NextBG/Filament_LED_Wall/Mechanical/0.2/装配体1.SLDASM

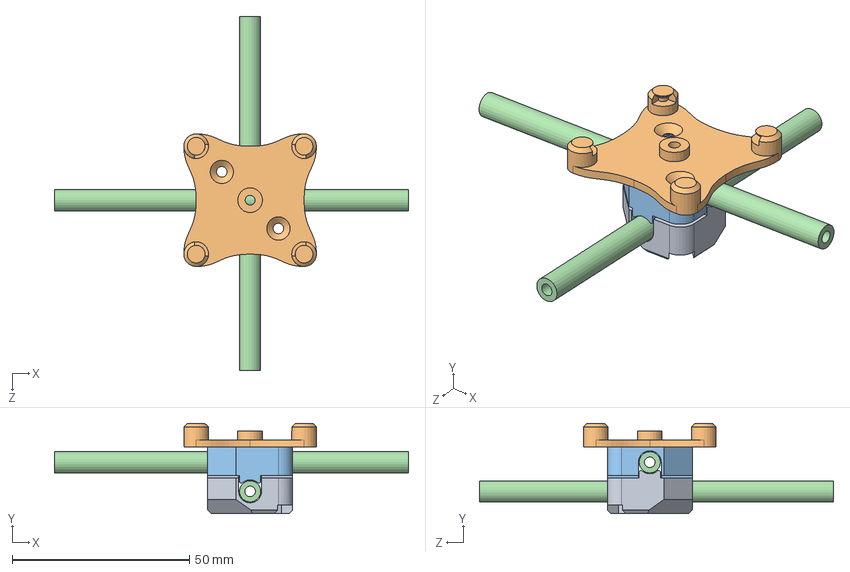
[picture p1: CAD file, 2021-04-25]
Mechanical/0.2/装配体1.SLDASM
100.0 x 25.5 x 100.0 mm
FrameHolder_tail
FrameHolder_mount
FrameHolder_top
Tube_4x6x100 x 2
