NextBG/Filament_LED_Wall/Mechanical/0.1/FrameHolder_Head.SLDPRT

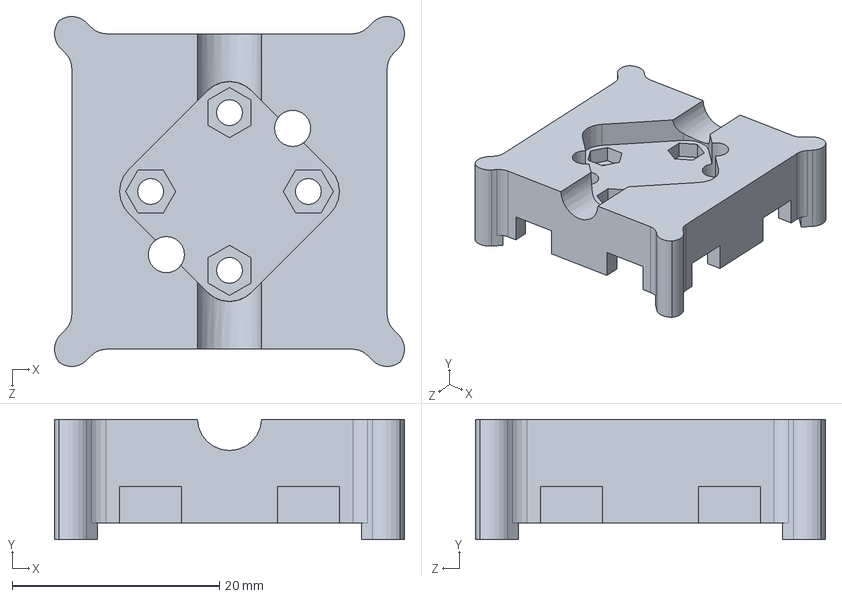
[picture p2: CAD file, 2021-04-15]
Mechanical/0.1/FrameHolder_Head.SLDPRT
33.8 x 11.6 x 33.8 mm
