NextBG/Filament_LED_Wall/Mechanical/0.2/FrameHolder_tail.SLDPRT

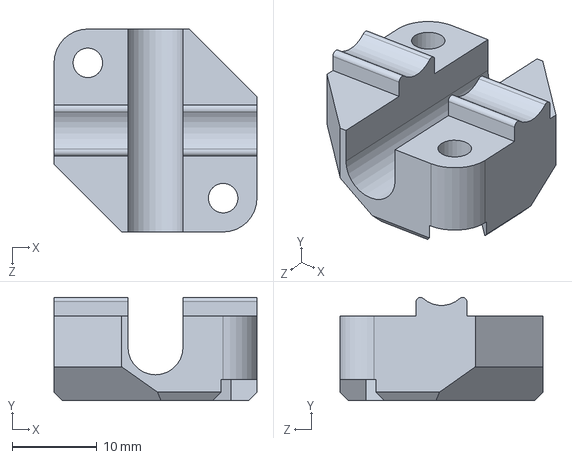
[picture p3: CAD file, 2021-04-25]
Mechanical/0.2/FrameHolder_tail.SLDPRT
24.0 x 12.2 x 24.0 mm
