NextBG/Filament_LED_Wall/Mechanical/0.1/FrameHolder_Tail.SLDPRT

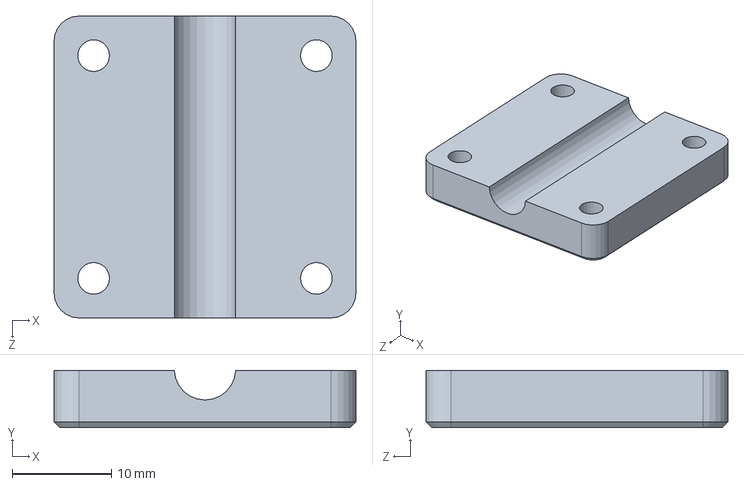
[picture p4: CAD file, 2021-04-15]
Mechanical/0.1/FrameHolder_Tail.SLDPRT
30.5 x 5.80 x 30.5 mm
