NextBG/Filament_LED_Wall/Mechanical/0.2/Tube_4x6x10.SLDPRT

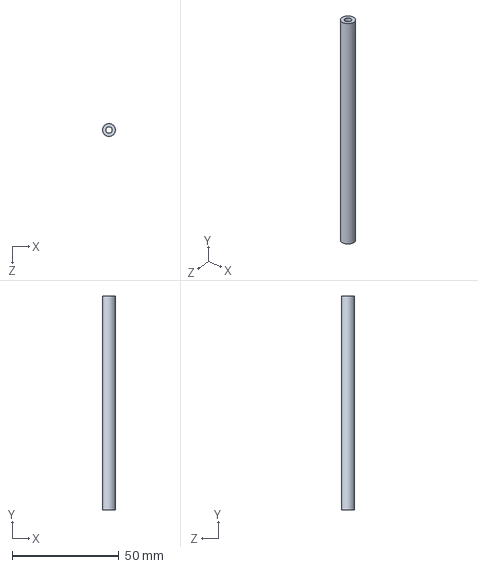
[picture p5: CAD file, 2021-04-25]
Mechanical/0.2/Tube_4x6x10.SLDPRT
6.00 x 100.0 x 6.00 mm
