NextBG/Filament_LED_Wall/Mechanical/0.1/FrameHolder_Middle.SLDPRT

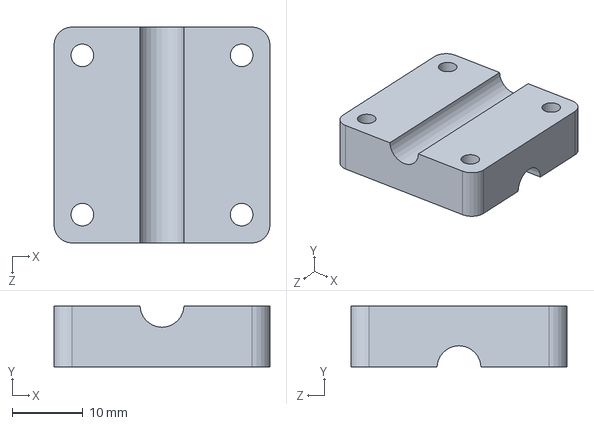
[picture p6: CAD file, 2021-04-15]
Mechanical/0.1/FrameHolder_Middle.SLDPRT
30.5 x 8.60 x 30.5 mm
