NextBG/Filament_LED_Wall/Mechanical/0.2/FrameHolder_mount.SLDPRT

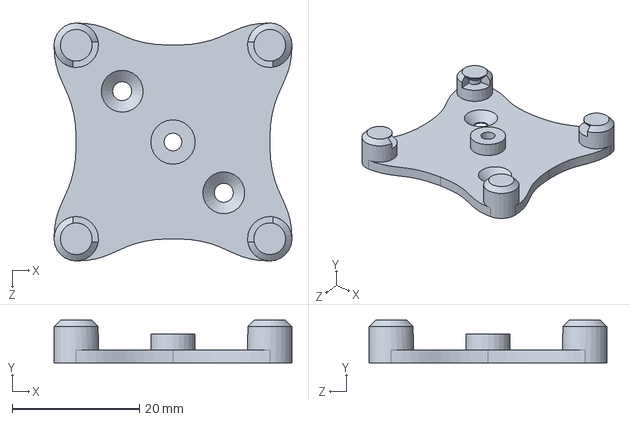
[picture p7: CAD file, 2021-04-25]
Mechanical/0.2/FrameHolder_mount.SLDPRT
37.5 x 6.70 x 37.5 mm
