NextBG/Filament_LED_Wall/Mechanical/0.2/FrameHolder_top.SLDPRT

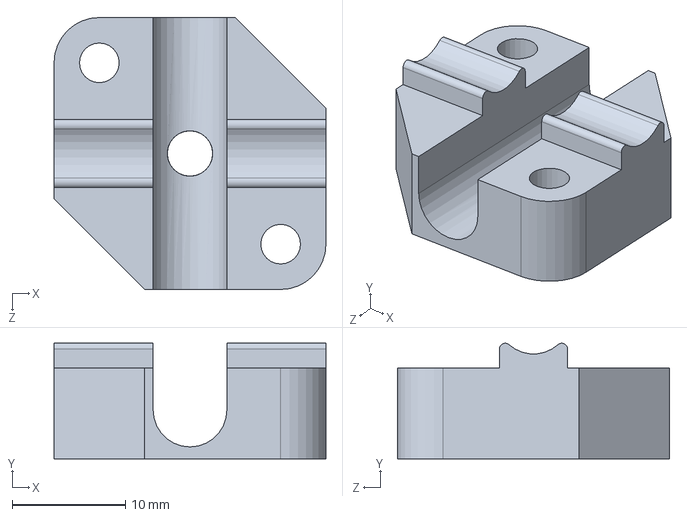
[picture p8: CAD file, 2021-04-25]
Mechanical/0.2/FrameHolder_top.SLDPRT
24.0 x 10.2 x 24.0 mm
