NextBG/Filament_LED_Wall/(list of files, cad)

Other CAD files:
Mechanical/0.2/Tube_4x6x100.SLDPRT
Mechanical/0.1/3DPrinting/FrameHolder_Head.STL
Mechanical/0.1/3DPrinting/FrameHolder_Middle.STL
Mechanical/0.1/3DPrinting/FrameHolder_Tail.STL
Mechanical/0.2/3Dprinting/FrameHolder_mount.STL
Mechanical/0.2/3Dprinting/FrameHolder_tail.STL
Mechanical/0.2/3Dprinting/FrameHolder_top.STL
