NextBG/Filament_LED_Wall/Hardware/FilaDock/fc.kicad_pcb

## KiCad design Hardware/FilaDock/fc.kicad_pcb (2021-09-17)

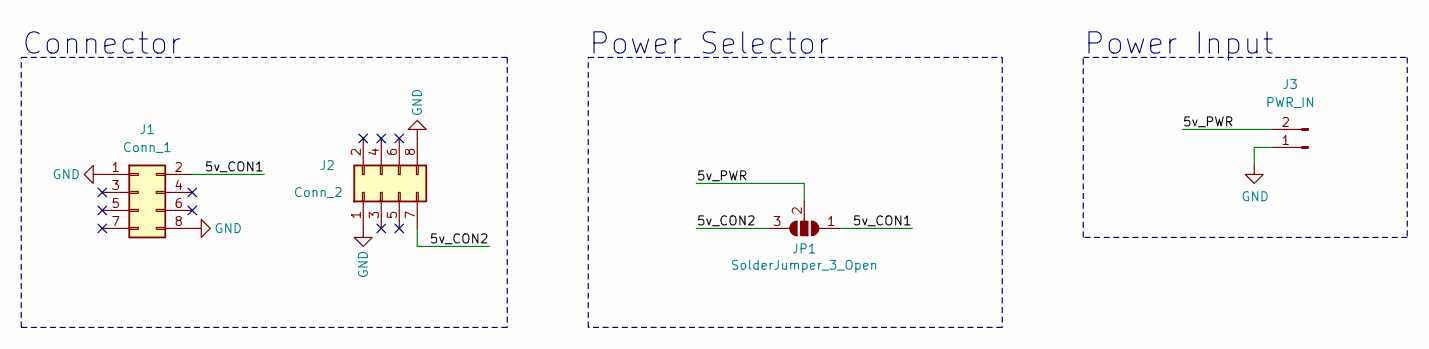
[picture p9: schematic fc.sch]

Parts:
J1: Conn_1; PinSocket_2x04_P2.54mm_Vertical
J2: Conn_2; PinSocket_2x04_P2.54mm_Vertical
J3: PWR_IN; PinHeader_1x02_P2.54mm_Horizontal
JP1: SolderJumper_3_Open; SolderJumper-3_P1.3mm_Open_RoundedPad1.0x1.5mm

Connections:
/5v_CON1: J1.2, JP1.1 (A)
/5v_CON2: J2.7, JP1.3 (B)
/5v_PWR: J3.2, JP1.2 (C)
GND: J1.1, J1.8, J2.1, J2.8, J3.1

Notes on the sheet:
Connector
Power Selector
Power Input

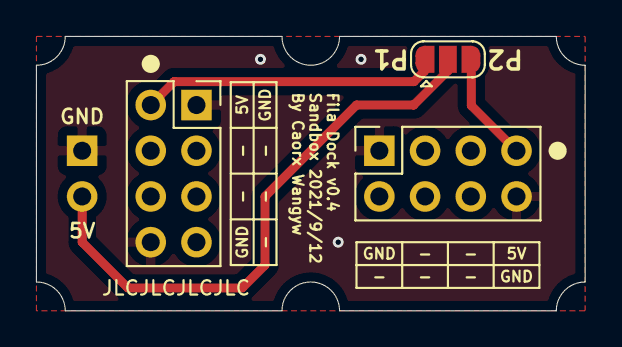
[picture p10: board Hardware/FilaDock/fc.kicad_pcb from above]

Board: 2 copper layers, 30.5 x 15.2 mm, 4 parts (1 on the bottom side), 4 nets.
