NextBG/Filament_LED_Wall/Hardware/FilaHead/fc.kicad_pcb

## KiCad design Hardware/FilaHead/fc.kicad_pcb (2021-05-04)

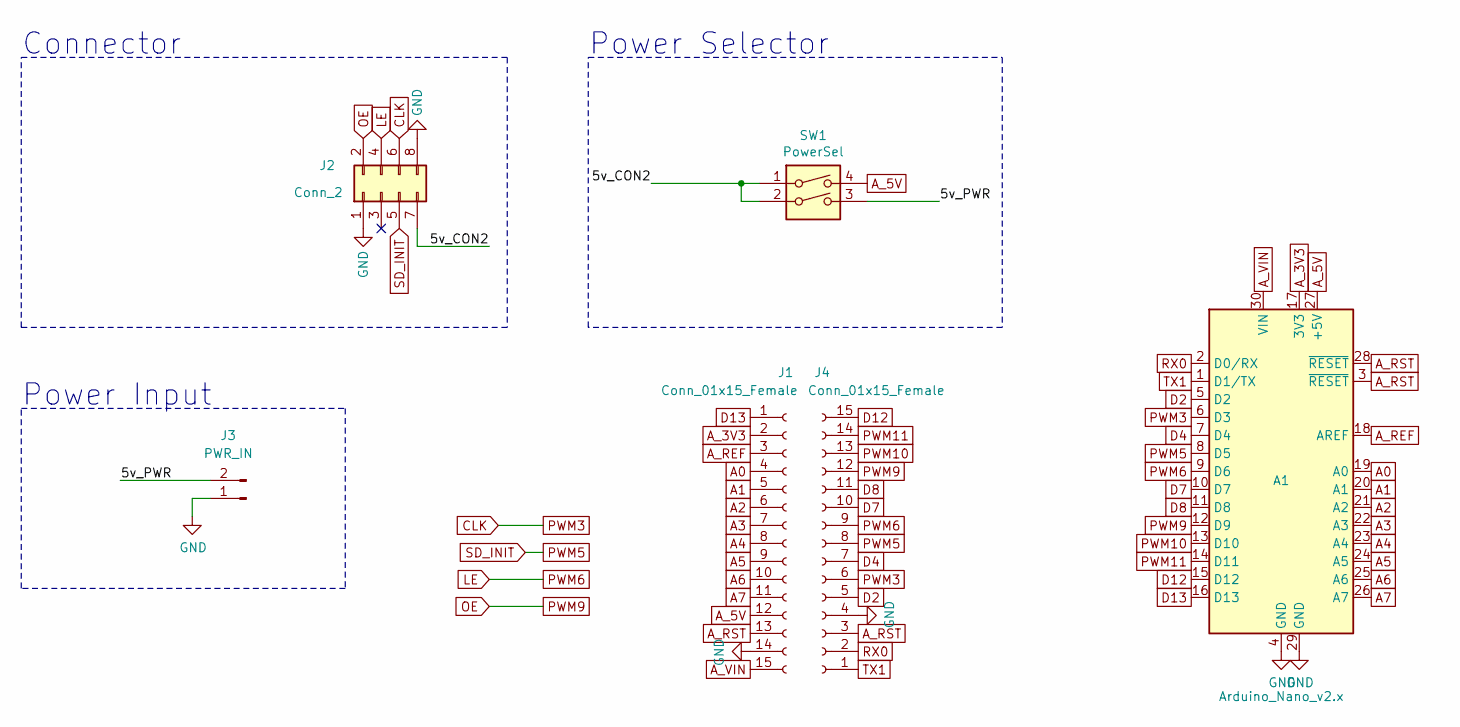
[picture p11: schematic fc.sch]

Parts:
A1: Arduino_Nano_v2.x; Arduino_Nano
J1, J4: Conn_01x15_Female; PinHeader_1x15_P2.54mm_Vertical
J2: Conn_2; PinSocket_2x04_P2.54mm_Vertical
J3: PWR_IN; PinHeader_1x02_P2.54mm_Horizontal
SW1: PowerSel; SW_DIP_SPSTx02_Slide_KingTek_DSHP02TS_W7.62mm_P1.27mm

Connections:
/5v_CON2: J2.7, SW1.1, SW1.2
/5v_PWR: J3.2, SW1.3
A0: A1.19 (A0), J1.4
A1: A1.20 (A1), J1.5
A2: A1.21 (A2), J1.6
A3: A1.22 (A3), J1.7
A4: A1.23 (A4), J1.8
A5: A1.24 (A5), J1.9
A6: A1.25 (A6), J1.10
A7: A1.26 (A7), J1.11
A_3V3: A1.17 (3V3), J1.2
A_5V: A1.27 (+5V), J1.12, SW1.4
A_REF: A1.18 (AREF), J1.3
A_RST: A1.3 (~RESET), A1.28 (~RESET), J1.13, J4.3
A_VIN: A1.30 (VIN), J1.15
CLK: A1.6 (D3), J2.6, J4.6
D2: A1.5 (D2), J4.5
D4: A1.7 (D4), J4.7
D7: A1.10 (D7), J4.10
D8: A1.11 (D8), J4.11
D12: A1.15 (D12), J4.15
D13: A1.16 (D13), J1.1
GND: A1.4 (GND), A1.29 (GND), J1.14, J2.1, J2.8, J3.1, J4.4
LE: A1.9 (D6), J2.4, J4.9
OE: A1.12 (D9), J2.2, J4.12
PWM5: A1.8 (D5), J2.5, J4.8
PWM10: A1.13 (D10), J4.13
PWM11: A1.14 (D11), J4.14
RX0: A1.2 (D0/RX), J4.2
TX1: A1.1 (D1/TX), J4.1

Notes on the sheet:
Connector
Power Selector
Power Input

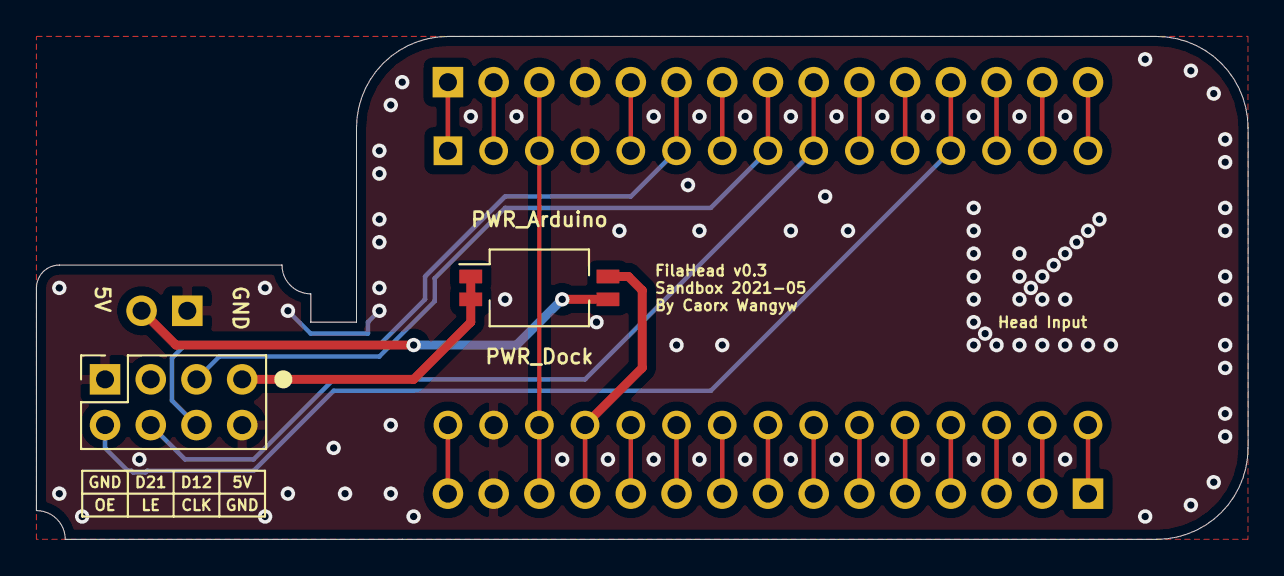
[picture p12: board Hardware/FilaHead/fc.kicad_pcb from above]

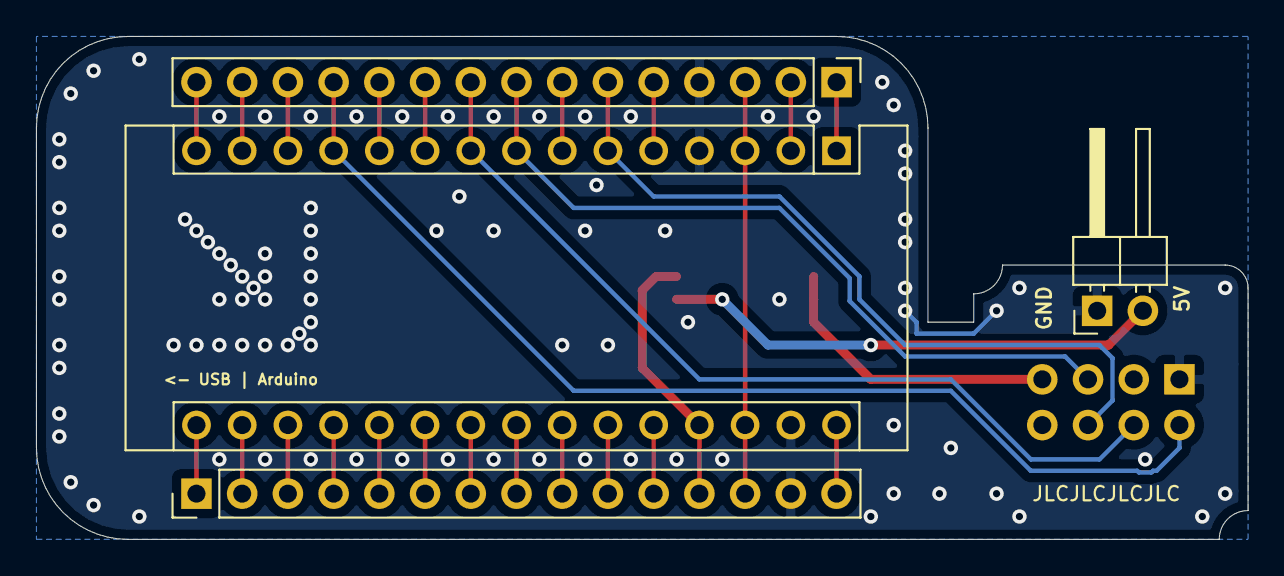
[picture p13: board Hardware/FilaHead/fc.kicad_pcb from below]

Board: 2 copper layers, 67.3 x 27.9 mm, 6 parts (4 on the bottom side), 30 nets.
