NextBG/Filament_LED_Wall/Hardware/FilamentLEDWall/FilamentLEDWall.kicad_pcb

## KiCad design Hardware/FilamentLEDWall/FilamentLEDWall.kicad_pcb (2021-04-15)

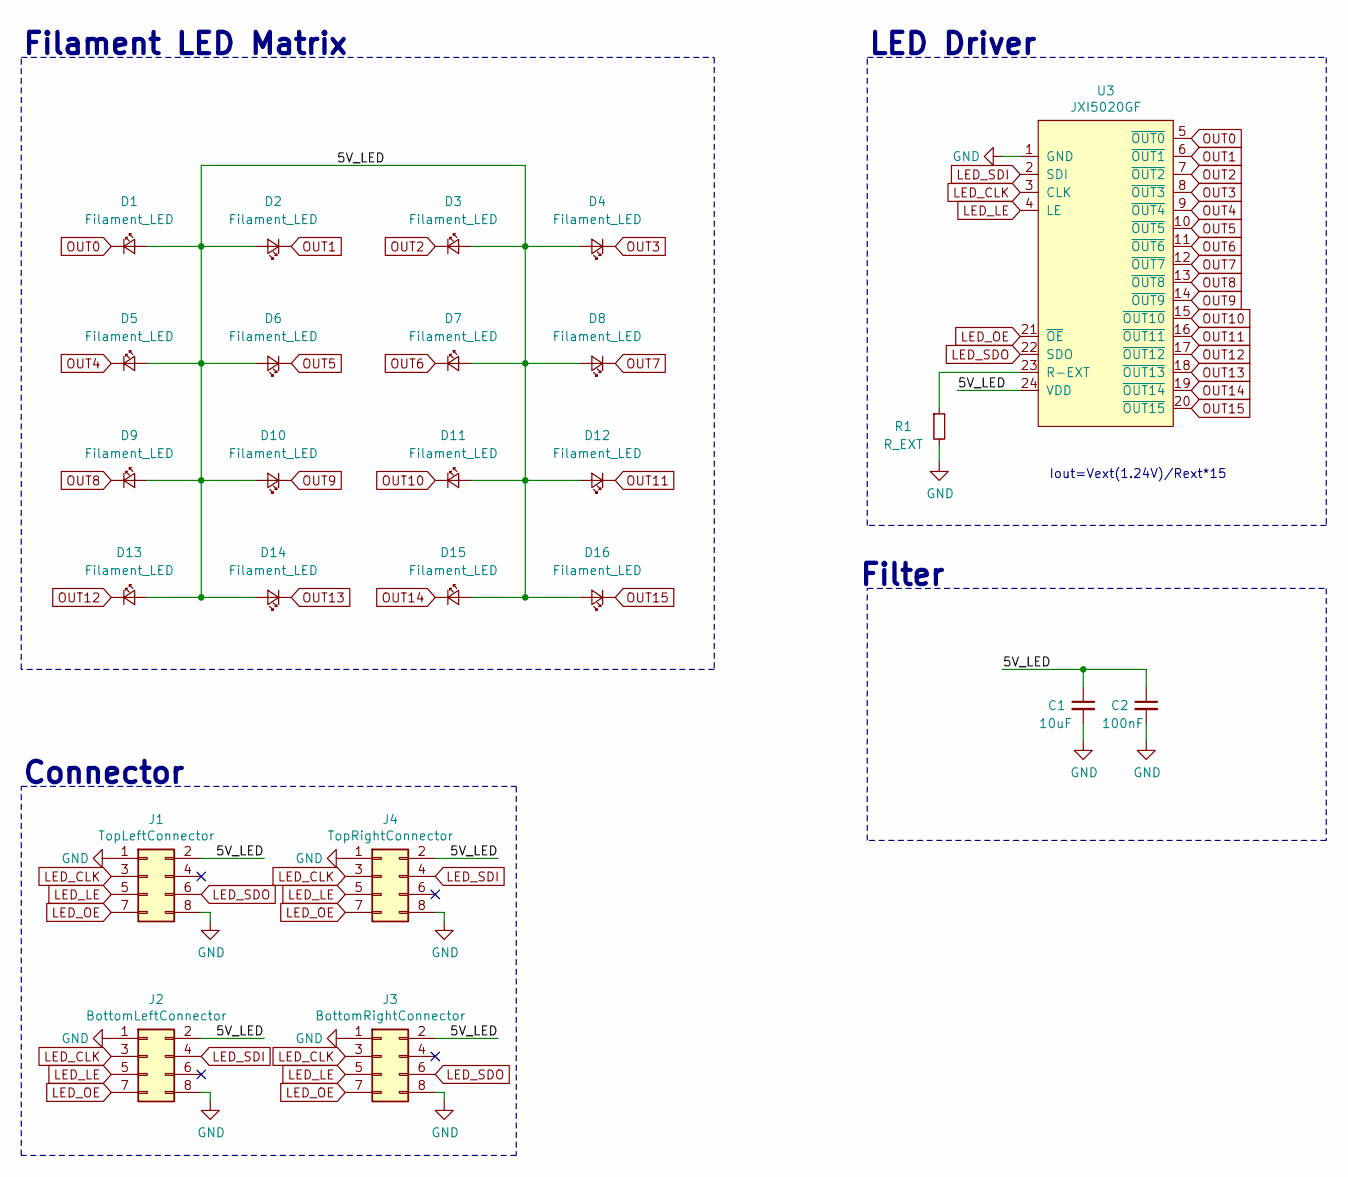
[picture p14: schematic FilamentLEDWall.sch, Filament LED Wall]

Parts:
C1: 10uF; C_0603_1608Metric_Pad1.05x0.95mm_HandSolder
C2: 100nF; C_0603_1608Metric_Pad1.05x0.95mm_HandSolder
D1, D2, D3, D4, D5, D6, D7, D8, D9, D10, D11, D12, D13, D14, D15, D16: Filament_LED; FilamentLED_30mm
J1: TopLeftConnector; PinHeader_2x04_P2.54mm_Vertical_SMD
J2: BottomLeftConnector; PinHeader_2x04_P2.54mm_Vertical_SMD
J3: BottomRightConnector; PinHeader_2x04_P2.54mm_Vertical_SMD
J4: TopRightConnector; PinHeader_2x04_P2.54mm_Vertical_SMD
R1: R_EXT; R_0603_1608Metric_Pad1.05x0.95mm_HandSolder
U3: JXI5020GF; Allegro_QSOP-24_3.9x8.7mm_P0.635mm

Connections:
/5V_LED: C1.1, C2.1, D1.2 (A), D2.2 (A), D3.2 (A), D4.2 (A), D5.2 (A), D6.2 (A), D7.2 (A), D8.2 (A), D9.2 (A), D10.2 (A), D11.2 (A), D12.2 (A), D13.2 (A), D14.2 (A), D15.2 (A), D16.2 (A), J1.2, J2.2, J3.2, J4.2, U3.24 (VDD)
GND: C1.2, C2.2, J1.1, J1.8, J2.1, J2.8, J3.1, J3.8, J4.1, J4.8, R1.2, U3.1 (GND)
LED_CLK: J1.3, J2.3, J3.3, J4.3, U3.3 (CLK)
LED_LE: J1.5, J2.5, J3.5, J4.5, U3.4 (LE)
LED_OE: J1.7, J2.7, J3.7, J4.7, U3.21 (~OE)
LED_SDI: J2.4, J4.4, U3.2 (SDI)
LED_SDO: J1.6, J3.6, U3.22 (SDO)
unnamed: R1.1, U3.23 (R-EXT)
OUT0: D1.1 (K), U3.5 (~OUT0)
OUT1: D2.1 (K), U3.6 (~OUT1)
OUT2: D3.1 (K), U3.7 (~OUT2)
OUT3: D4.1 (K), U3.8 (~OUT3)
OUT4: D5.1 (K), U3.9 (~OUT4)
OUT5: D6.1 (K), U3.10 (~OUT5)
OUT6: D7.1 (K), U3.11 (~OUT6)
OUT7: D8.1 (K), U3.12 (~OUT7)
OUT8: D9.1 (K), U3.13 (~OUT8)
OUT9: D10.1 (K), U3.14 (~OUT9)
OUT10: D11.1 (K), U3.15 (~OUT10)
OUT11: D12.1 (K), U3.16 (~OUT11)
OUT12: D13.1 (K), U3.17 (~OUT12)
OUT13: D14.1 (K), U3.18 (~OUT13)
OUT14: D15.1 (K), U3.19 (~OUT14)
OUT15: D16.1 (K), U3.20 (~OUT15)

Notes on the sheet:
Iout=Vext(1.24V)/Rext*15
LED Driver
Filament LED Matrix
Connector
Filter

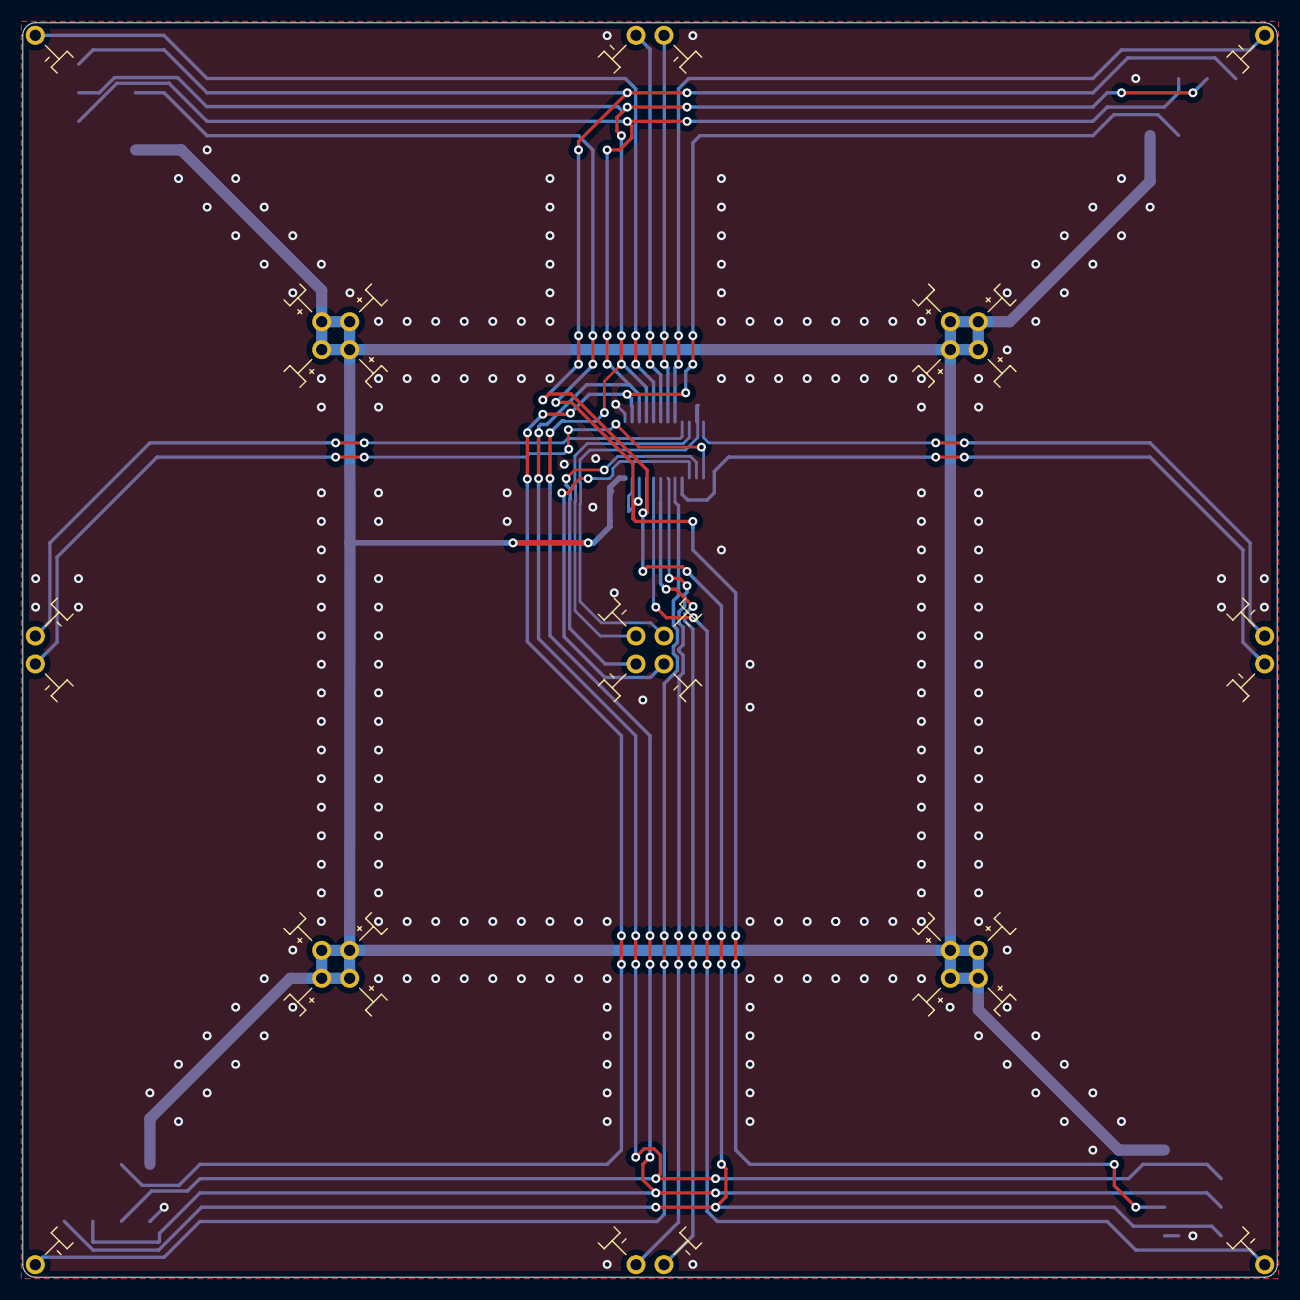
[picture p15: board FilamentLEDWall.kicad_pcb from above]

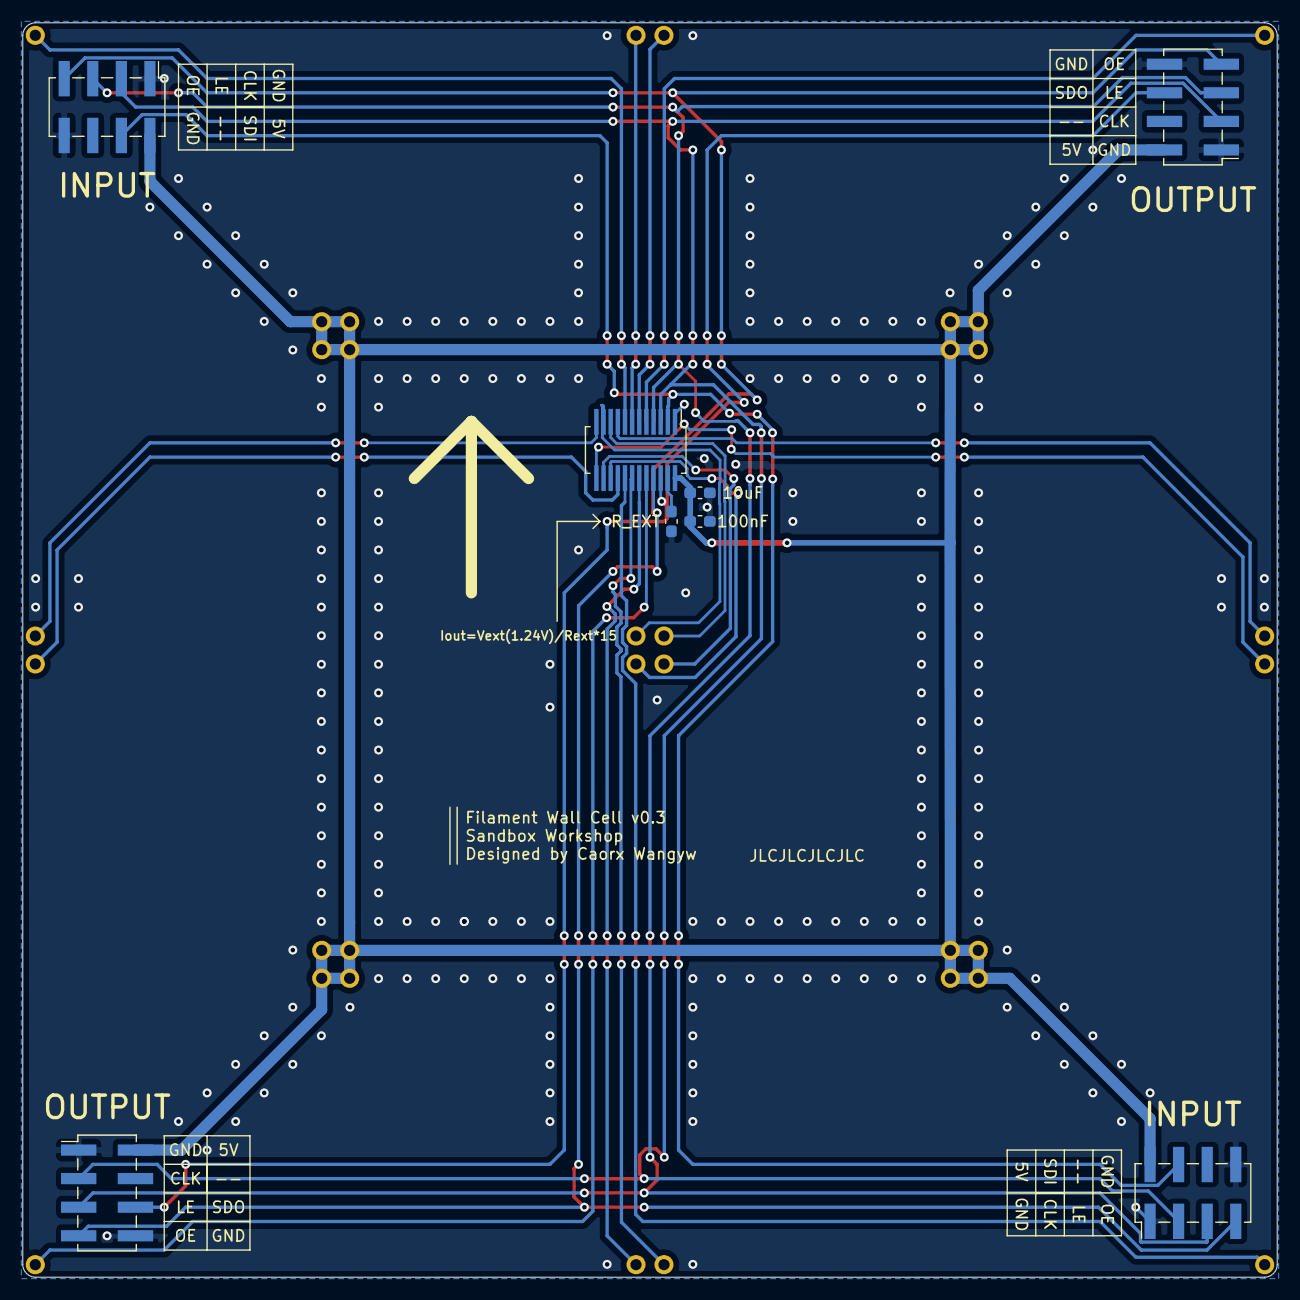
[picture p16: board FilamentLEDWall.kicad_pcb from below]

Board: 2 copper layers, 111.5 x 111.5 mm, 24 parts (8 on the bottom side), 24 nets.
