NextBG/Filament_LED_Wall/(commit log)

2021-03-12 updated PCB
    [FilamentLEDWall.kicad_pcb, FilamentLEDWall.sch]
2021-04-01 updated circuit
    [FilamentLEDWall.kicad_pcb, FilamentLEDWall.sch]
2021-04-02 init connector
    [fc.kicad_pcb, fc.sch]
2021-04-02 Updated light PCB v0.1
    [FilamentLEDWall-B_Cu.gbr, FilamentLEDWall-B_Mask.gbr, FilamentLEDWall-B_Paste.gbr, FilamentLEDWall-B_SilkS.gbr, FilamentLEDWall-Edge_Cuts.gbr, FilamentLEDWall-F_Cu.gbr, FilamentLEDWall-F_Mask.gbr, FilamentLEDWall-F_Paste.gbr]
2021-04-04 Updated LED Board to v0.2
    [FilamentLEDWall-B_Cu.gbr, FilamentLEDWall-B_Mask.gbr, FilamentLEDWall-B_Paste.gbr, FilamentLEDWall-B_SilkS.gbr, FilamentLEDWall-Edge_Cuts.gbr, FilamentLEDWall-F_Cu.gbr, FilamentLEDWall-F_Mask.gbr, FilamentLEDWall-F_Paste.gbr]
2021-04-04 created Placeholder & Head[WIP]
    [fc.kicad_pcb, fc.sch]
2021-04-05 updated arduino nano connector
    [fc.sch]
2021-04-05 updated hardware and RPi codes
    [fc.sch]
2021-04-05 Updated Fila Head
    [fc.kicad_pcb, fc.sch]
2021-04-05 updated and generated Header connector
    [fc.kicad_pcb]
2021-04-07 updated wall cell and connector
    [FilamentLEDWall.kicad_pcb, FilamentLEDWall.sch, fc.kicad_pcb, fc.sch]
2021-04-07 updated packages
    [fc.kicad_pcb, fc.sch]
2021-04-15 merged all
    [FilamentLEDWall.kicad_pcb, FilamentLEDWall.sch, FrameHolder_Head.SLDPRT, FrameHolder_Head.STL, FrameHolder_Middle.SLDPRT, FrameHolder_Middle.STL, FrameHolder_Tail.SLDPRT, FrameHolder_Tail.STL]
2021-04-25 Updated 3dprinted frame
    [FrameHolder_Head.SLDPRT, FrameHolder_Head.STL, FrameHolder_Middle.SLDPRT, FrameHolder_Middle.STL, FrameHolder_Tail.SLDPRT, FrameHolder_Tail.STL, FrameHolder_mount.SLDPRT, FrameHolder_mount.STL]
2021-04-25 Updated FilaDock component
    [fc.kicad_pcb, fc.sch]
2021-05-02 updated FilaHead v0.3
    [fc.kicad_pcb, fc.sch]
2021-05-04 upload latest head PCB
    [fc.kicad_pcb]
2021-05-04 optimized pcb
    [fc.kicad_pcb]
2021-05-04 rounded corners
    [fc.kicad_pcb]
2021-05-05 reformatted arduino
2021-05-05 added new arduino logic
    [!] Warning: this is not based on the latest version. Should use the one in SDB computer to OVERWRITE this.
